mrberman87/op-amp/artifacts/freq_response_openloop.png

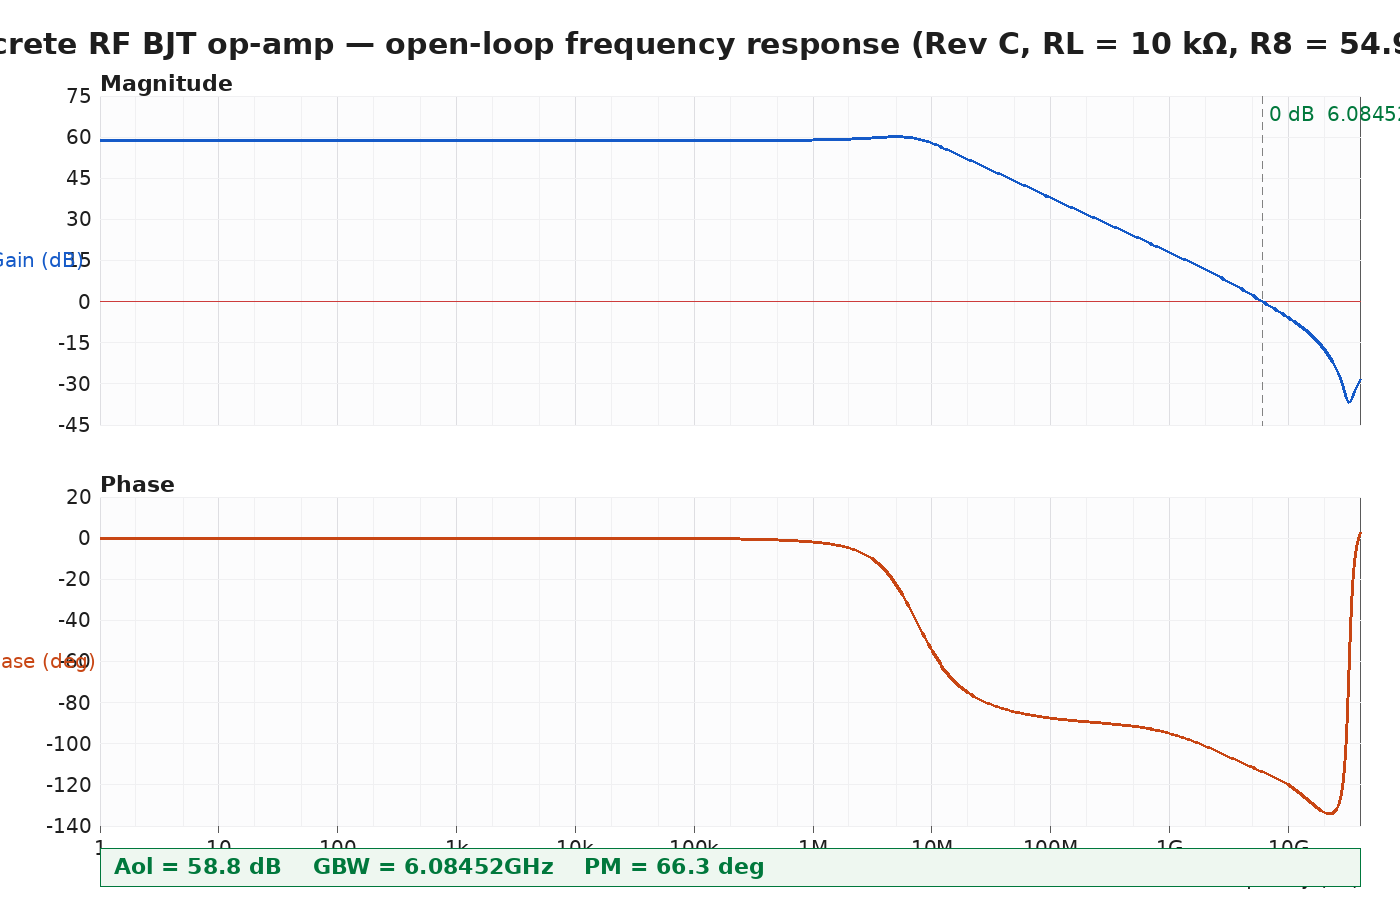
artifacts/freq_response_openloop.png
