mrberman87/op-amp/sim/_12.cir

R6-bypass R7=680 Cc1=4p
.include v8.inc
.param R7v=680 Rzv=0 Cc1v=4p
C6 n_q5e VCC 100n
RINM INM 0 1u
VSRC INP 0 DC 0 AC 1
RL   OUT 0 10k
.control
op
ac dec 30 10 1gig
print v(out)
.endc
.end
