mrberman87/op-amp/sim/_4.cir

v4 cascoded mirror C3=22p
.include v4.inc
.param C3v=22p
RINM INM 0 1u
VSRC INP 0 DC 0 AC 1
RL   OUT 0 10k
.control
op
print v(out) v(n_x) v(n_mc) v(n_vb) v(n_q5c) vcc#branch
ac dec 24 10 1gig
print v(out)
.endc
.end
