mrberman87/op-amp/sim/_7.cir

v7 miller+null Cc1=33p Rz=1k
.include v7.inc
.param C3v=0.1p Rzv=1k
RINM INM 0 1u
VSRC INP 0 DC 0 AC 1
RL   OUT 0 10k
.control
op
ac dec 30 10 1gig
print v(out)
.endc
.end
