mrberman87/op-amp/opamp.kicad_pcb

## KiCad design opamp.kicad_pcb (2026-11-13)

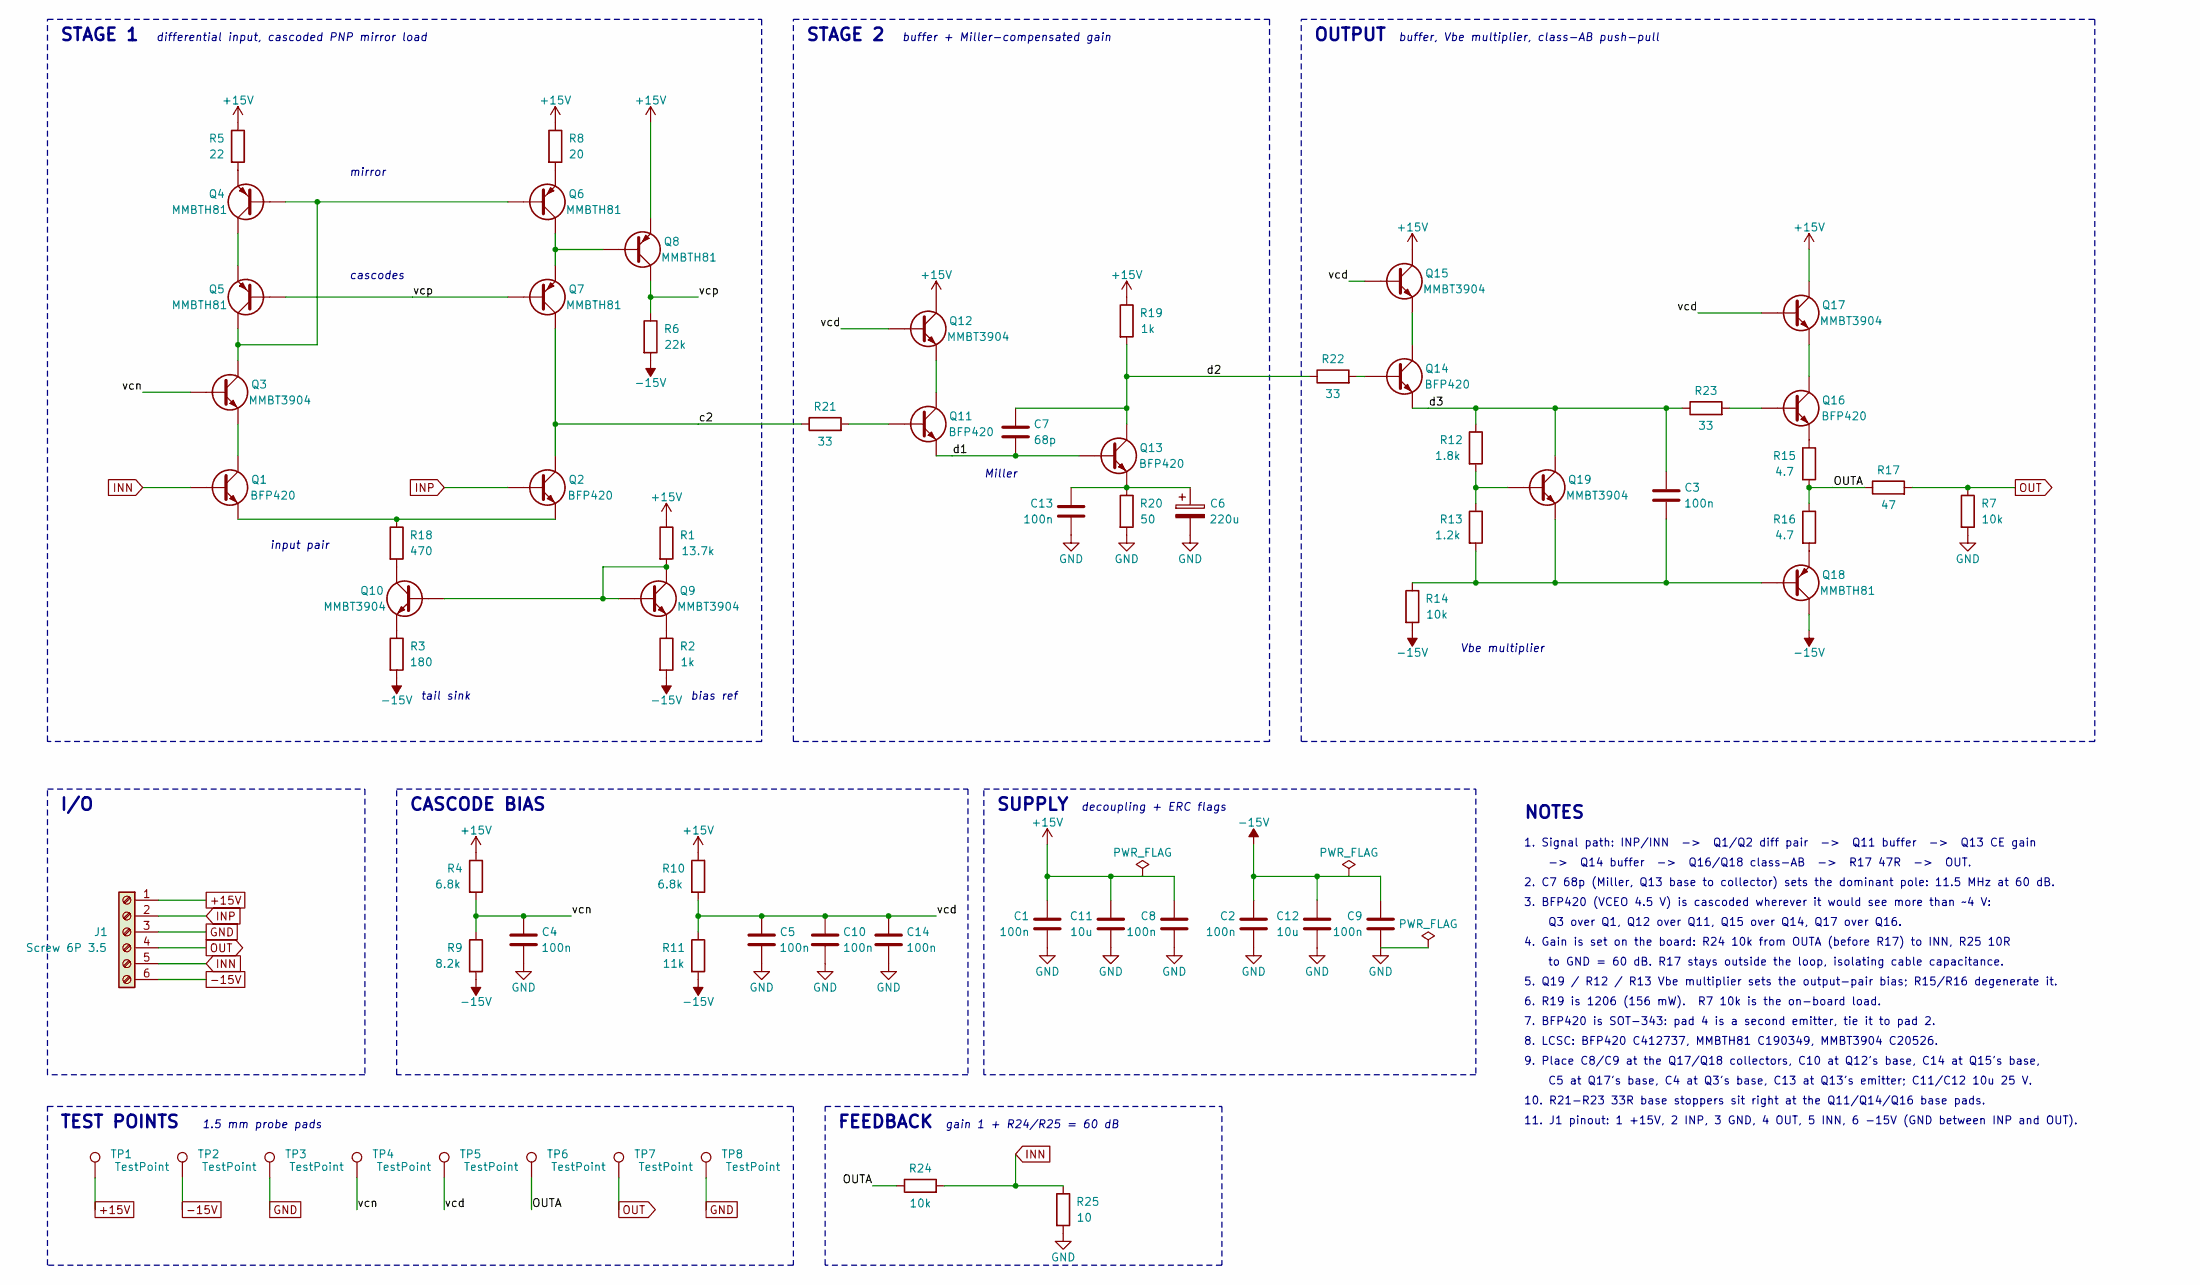
[picture p2: schematic opamp.kicad_sch, Discrete Two-Stage Op Amp (Rev E)]

Parts:
C1, C2, C3, C4, C5, C8, C9, C10, C13, C14: 100n; C_0603_1608Metric
C6: 220u; CP_Elec_6.3x5.4
C7: 68p; C_0603_1608Metric
C11, C12: 10u; C_1206_3216Metric
J1: Screw 6P 3.5; TerminalBlock_Phoenix_PT-1,5-6-3.5-H_1x06_P3.50mm_Horizontal
Q1, Q2, Q11, Q13, Q14, Q16: BFP420; SOT-343_SC-70-4; MPN BFP420; LCSC C412737
Q3, Q9, Q10, Q12, Q15, Q17, Q19: MMBT3904; SOT-23; MPN MMBT3904; LCSC C20526
Q4, Q5, Q6, Q7, Q8, Q18: MMBTH81; SOT-23; MPN MMBTH81; LCSC C190349
R1: 13.7k; R_0603_1608Metric
R2: 1k; R_0603_1608Metric
R3: 180; R_0603_1608Metric
R4, R10: 6.8k; R_0603_1608Metric
R5: 22; R_0603_1608Metric
R6: 22k; R_0603_1608Metric
R7, R14, R24: 10k; R_0603_1608Metric
R8: 20; R_0603_1608Metric
R9: 8.2k; R_0603_1608Metric
R11: 11k; R_0603_1608Metric
R12: 1.8k; R_0603_1608Metric
R13: 1.2k; R_0603_1608Metric
R15, R16: 4.7; R_0603_1608Metric
R17: 47; R_0603_1608Metric
R18: 470; R_0603_1608Metric
R19: 1k; R_1206_3216Metric
R20: 50; R_0603_1608Metric
R21, R22, R23: 33; R_0603_1608Metric
R25: 10; R_0603_1608Metric
TP1, TP2, TP3, TP4, TP5, TP6, TP7, TP8: TestPoint; TestPoint_Pad_D1.5mm

Connections:
+15V: C1.1, C8.1, C11.1, J1.1, Q8.2 (E), Q12.3 (C), Q15.3 (C), Q17.3 (C), R1.1, R4.1, R5.1, R8.1, R10.1, R19.1, TP1.1
-15V: C2.1, C9.1, C12.1, J1.6, Q18.3 (C), R2.2, R3.2, R6.2, R9.2, R11.2, R14.2, TP2.1
GND: C1.2, C2.2, C4.2, C5.2, C6.2, C8.2, C9.2, C10.2, C11.2, C12.2, C13.2, C14.2, J1.3, R7.2, R20.2, R25.2, TP3.1, TP8.1
INN: J1.5, Q1.1 (B), R24.2, R25.1
INP: J1.2, Q2.1 (B)
OUT: J1.4, R7.1, R17.2, TP7.1
OUTA: R15.2, R16.1, R17.1, R24.1, TP6.1
T: Q1.2 (E), Q1.4, Q2.2 (E), Q2.4, R18.1
Tc: Q10.3 (C), R18.2
a1: Q1.3 (C), Q3.2 (E)
b9: C3.2, Q18.1 (B), Q19.2 (E), R13.2, R14.1
c1: Q3.3 (C), Q4.1 (B), Q5.3 (C), Q6.1 (B)
c2: Q2.3 (C), Q7.3 (C), R21.1
c2b: Q11.1 (B), R21.2
d1: C7.2, Q11.2 (E), Q11.4, Q13.1 (B)
d2: C7.1, Q13.3 (C), R19.2, R22.1
d2b: Q14.1 (B), R22.2
d3: C3.1, Q14.2 (E), Q14.4, Q19.3 (C), R12.1, R23.1
d3b: Q16.1 (B), R23.2
db: Q19.1 (B), R12.2, R13.1
e1: C6.1, C13.1, Q13.2 (E), Q13.4, R20.1
e3: Q4.2 (E), R5.2
e4: Q6.2 (E), R8.2
n1: Q4.3 (C), Q5.2 (E)
n2: Q6.3 (C), Q7.2 (E), Q8.1 (B)
n8: Q16.2 (E), Q16.4, R15.1
n9: Q18.2 (E), R16.2
vcd: C5.1, C10.1, C14.1, Q12.1 (B), Q15.1 (B), Q17.1 (B), R10.2, R11.1, TP5.1
vcn: C4.1, Q3.1 (B), R4.2, R9.1, TP4.1
vcp: Q5.1 (B), Q7.1 (B), Q8.3 (C), R6.1
veb: Q9.2 (E), R2.1
vet: Q10.2 (E), R3.1
vref: Q9.1 (B), Q9.3 (C), Q10.1 (B), R1.2
x8: Q11.3 (C), Q12.2 (E)
x9: Q14.3 (C), Q15.2 (E)
xo: Q16.3 (C), Q17.2 (E)

Notes on the sheet:
STAGE 1
differential input, cascoded PNP mirror load
STAGE 2
buffer + Miller-compensated gain
OUTPUT
buffer, Vbe multiplier, class-AB push-pull
I/O
CASCODE BIAS
SUPPLY
decoupling + ERC flags
TEST POINTS
1.5 mm probe pads
FEEDBACK
gain 1 + R24/R25 = 60 dB
NOTES
1. Signal path: INP/INN -> Q1/Q2 diff pair -> Q11 buffer -> Q13 CE gain
-> Q14 buffer -> Q16/Q18 class-AB -> R17 47R -> OUT.
2. C7 68p (Miller, Q13 base to collector) sets the dominant pole: 11.5 MHz at 60 dB.
3. BFP420 (VCEO 4.5 V) is cascoded wherever it would see more than ~4 V:
Q3 over Q1, Q12 over Q11, Q15 over Q14, Q17 over Q16.
4. Gain is set on the board: R24 10k from OUTA (before R17) to INN, R25 10R
to GND = 60 dB. R17 stays outside the loop, isolating cable capacitance.
5. Q19 / R12 / R13 Vbe multiplier sets the output-pair bias; R15/R16 degenerate it.
6. R19 is 1206 (156 mW). R7 10k is the on-board load.
7. BFP420 is SOT-343: pad 4 is a second emitter, tie it to pad 2.
8. LCSC: BFP420 C412737, MMBTH81 C190349, MMBT3904 C20526.
9. Place C8/C9 at the Q17/Q18 collectors, C10 at Q12's base, C14 at Q15's base,
C5 at Q17's base, C4 at Q3's base, C13 at Q13's emitter; C11/C12 10u 25 V.
10. R21-R23 33R base stoppers sit right at the Q11/Q14/Q16 base pads.
11. J1 pinout: 1 +15V, 2 INP, 3 GND, 4 OUT, 5 INN, 6 -15V (GND between INP and OUT).
mirror
cascodes
input pair
tail sink
bias ref
Miller
Vbe multiplier

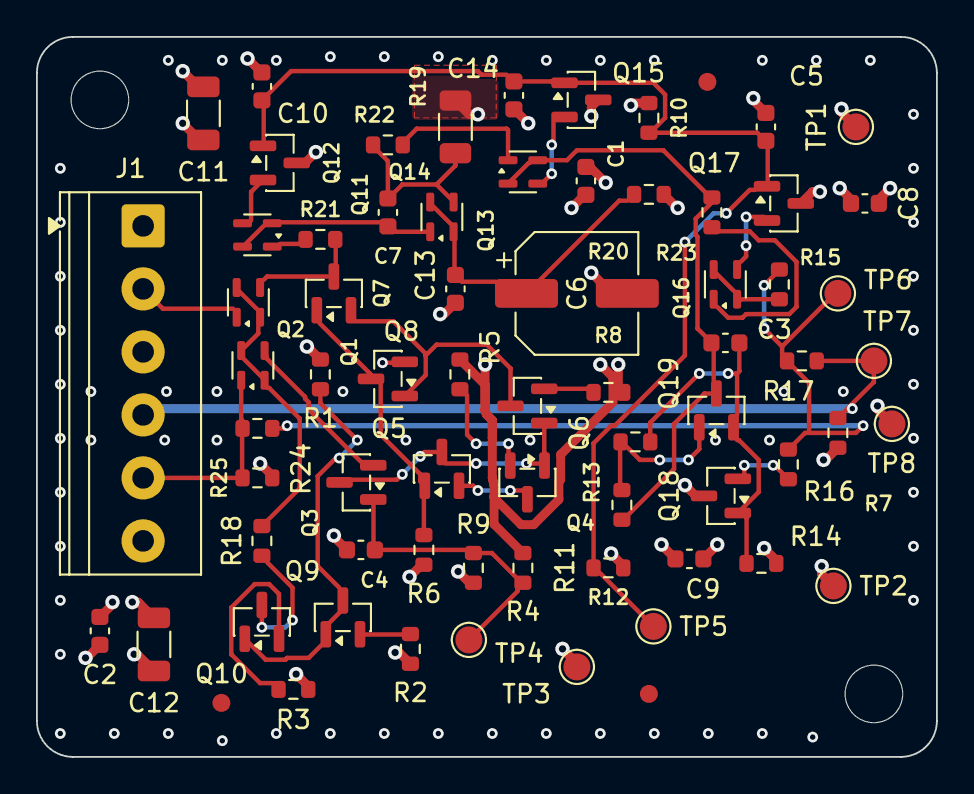
[picture p3: board opamp.kicad_pcb from above]

Board: 4 copper layers, 50.0 x 40.0 mm, 72 parts (0 on the bottom side), 36 nets.

Other parts of the board:
FID1, FID2, FID3: Fiducial; Fiducial_1mm_Mask2mm
H1, H2: MountingHole; MountingHole_3.2mm_M3
