mrberman87/op-amp/(commit log)

2026-10-14 Initial commit: op-amp KiCad project, schematic generator, and SPICE sims
    [opamp.kicad_pcb, opamp.kicad_sch]
2026-10-16 Fix Rev-C schematic wiring, replace offset trimmer with fixed R8
    The schematic generator drew a wire-based Rev-C (BFP420/BFP520) design, but
    its coordinates were off-grid for the J1 connector stubs and the C1/C2
    decoupling power symbols, so those pins were silently unconnected. kicad-cli
    reported 36 ERC violations (16 errors); it is now 0. The earlier "ERC clean"
    claim came from a tool that did not catch it.
    - gen_sch_rf.py: land the J1 stubs on the real pin coordinates (x 45.08->45.72,
    y +0.17) and place the C1/C2 power symbols on the capacitor pins (x 255->254).
    - Replace the RV1 100R offset trimmer with a fixed R8 = 54.9R (E96) that nulls
    the amplifier's *systematic* input offset (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
    [opamp.kicad_sch]
2026-10-16 Add TODO.md with the open work for Rev C
    Captures the two items left in flight (LCSC sourcing confirmation, the TNOM
    model bug) plus the follow-ups the schematic-wiring bug exposed:
    - LCSC: the jlcsearch index that declared BFP420/BFP520 unavailable is
    incomplete; LCSC's own autocomplete endpoint recognises BFP420H6327 and
    BFP520H6327. Needs C-codes, stock and package confirmation before the
    sourcing strategy is settled. Includes a working/broken endpoint inventory
    so the dead ends are not re-probed.
    - Transistor package / footprint reconciliation (SOT-23 vs SOT-343).
    - TNOM=300/298 model bug: impact measured, three files to change, docs to
    refresh. Decision still open.
    - An ER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
2026-11-13 Redraw schematic, place 50x40 mm board, apply layout review fixes
    Schematic (gen_sch_rf.py / gen_sch.py): redrawn for readability - signal
    path drawn as wires left to right, aligned rails, named blocks, references
    beside their parts, transistor pin numbers hidden, designer notes. Netlist
    pin groupings unchanged except the decoupling added below; ERC clean and
    the closed-loop netlist sim still meets 59.91 dB / 11.47 MHz.
    Board (place.py, in place; J1 lock kept): 50 x 40 mm outline, stage 1 laid
    out as a ring on its side so INP/INN need no crossings, output stage on the
    right edge over the matching In2.Cu rail, R17/R7 bottom-right with an edge
    strip reserved for the OUT return. After a review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
    [opamp.kicad_pcb, opamp.kicad_sch]
2026-11-13 Define the physical 4-layer stack-up in the board
    The board carried only a 1.6 mm total and generic "signal" inner layers.
    set_stackup.py writes the real build into the file: 1 oz outer / 0.5 oz
    inner copper, 0.21 mm 7628 prepreg between each outer layer and its plane,
    1.065 mm core, HAL lead-free finish (1.606 mm total). In1.Cu (GND) and
    In2.Cu (rails) are now typed as power planes. Layer assignment unchanged:
    every F.Cu trace references the solid In1 GND, and the In2 rail split is
    referenced to the B.Cu GND pour.
    [opamp.kicad_pcb]
2026-11-13 Route the board; screw terminal, on-board feedback, review fixes
    Routing (route.py, new): grid A* router run inside pcbnew. Signals on F.Cu
    at 0/45/90 deg over the solid In1 GND, B.Cu only for OUT and short DC-bias
    jumpers, rail/GND fanouts into the correct In2 pour, GND stitching round the
    perimeter, R19 thermal copper. 577 segments, 113 vias; KiCad DRC 0
    violations / 0 unconnected under the project net-class rules.
    Board changes requested: 2 mm rounded corners; C1/C11 moved to the upper
    (+15 V) half; J1 is now a 6-way 3.5 mm screw terminal on the left edge.
    Fixes from two review + adversarial-review passes on the routed board:
    - feedback was simulated from OUTA but J1 only exposed OUT, p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
    [opamp.kicad_pcb, opamp.kicad_sch]
2026-11-13 Re-floorplan and re-route: signal-flow placement, GND corridor, tidy routing
    Placement (place.py)
    - Floorplan follows the signal: stage 1 beside J1's inputs, stage 2 along
    the top with Q13 facing its pins (no crossings on the high-Z / AC-ground
    nets), output stage as one column across a new In2 GND corridor with the
    Vbe multiplier between the output devices.
    - --polish mode: keep the placement and seat parts by rule (SNUG): base
    stoppers on their bases, bypass caps on their pins; never accepts a spot
    that adds a no-cross crossing. Tight gap allowed for stoppers and matched
    pairs. Restores opamp.kicad_pro after saving (SaveBoard was clobbering it).
    - J1 re-pinned to the board: 1 +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
    [opamp.kicad_pcb, opamp.kicad_sch]
